enriquewph/Entrenador-pic/Entrenador_rev1/Render 3D.pdf

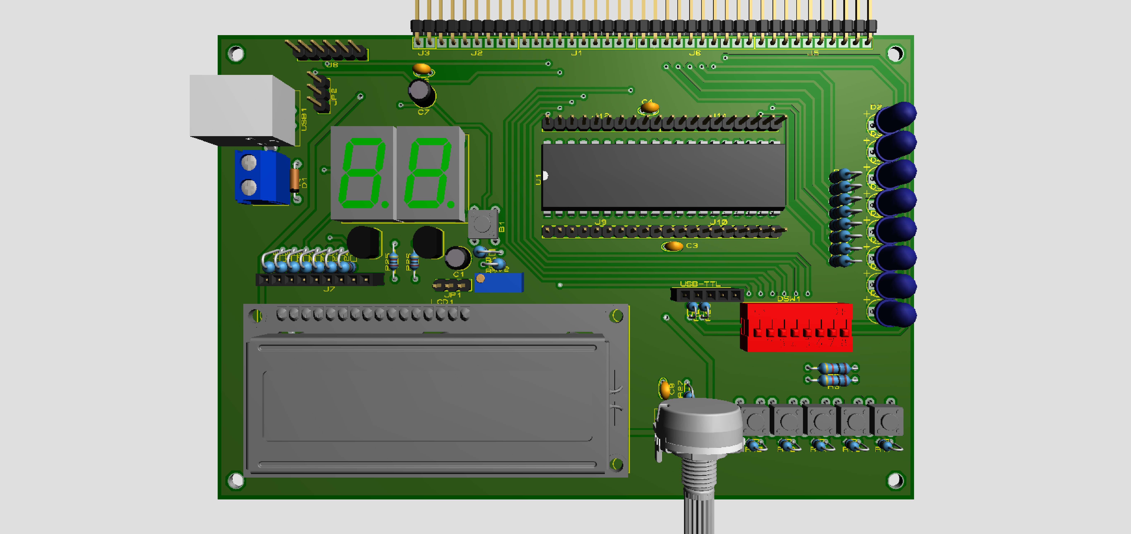
[picture p4: figure]
