enriquewph/Entrenador-pic/Entrenador_rev2/fotos_esquematico/BOM.pdf

Componente | Cantidad
Capacitor Electrolitico 1uFx16v | 1
Capacitor Electrolitico 100uFx16v | 1
Capacitor Cerámico 100nF | 6
Capacitor Cerámico 22pF | 2
Bornera 2 Terminales | 1
Tira de 40 pines hembra 2.54mm | 2
Tira de 40 pines macho 2.54mm | 2
Tira de 40 pines macho 90º 2.54mm | 1
Resistencia SMD 1206 4.7K | 3
Resistencia SMD 1206 10K | 8
Resistencia SMD 1206 470ohm | 7
Resistencia 1/4W THT 220ohm | 1
Trimmer 5k Multivuelta Vertical | 1
Led SMD 1206 Rojo | 7
Integrado SMD SOIC MCP2200-I/SO | 1
Microcontrolador DIP40 | 1
Optoacoplador AC 4N25 | 1
Regulador LM7805 TO-220 | 1
Zocalo DIP40 | 1
Pulsador 5x5mm | 4
Jack DC 2.5mm | 1
Dipswitch 8 bits Vertical | 1
Jumper | 3
Potenciometro 10k (Normal) | 1
Conector USB - B Hembra THT | 1
Cristal 12MHz Bajo perfil | 1
LCD 16x2 | 1
Diodo 1N4007 | 1
Placa lista p/entrenador | 1
Pies para placa | 4
