enriquewph/Entrenador-pic/Entrenador_rev3/Sch entrenador ITS Villada v1.pdf

# VCC

# MEMORIA

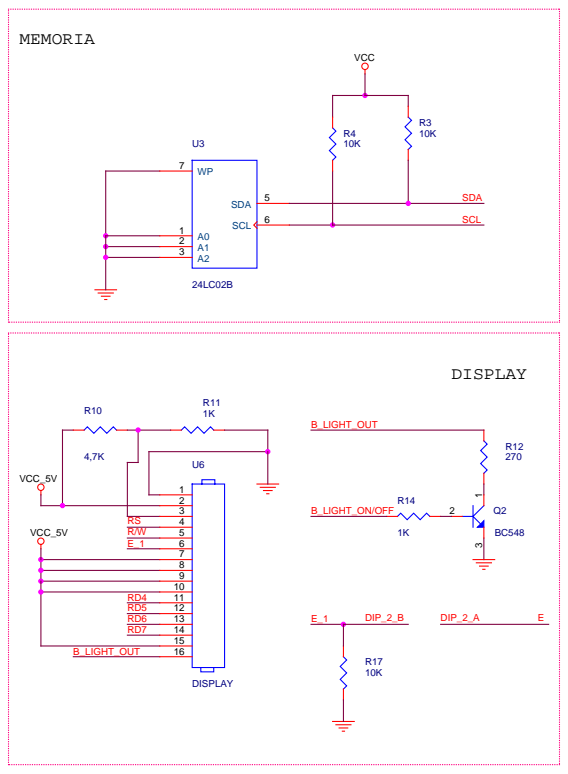
[picture p5: page 1]

VCC_5V | POTENCIA EN AC

## CRUCE_0

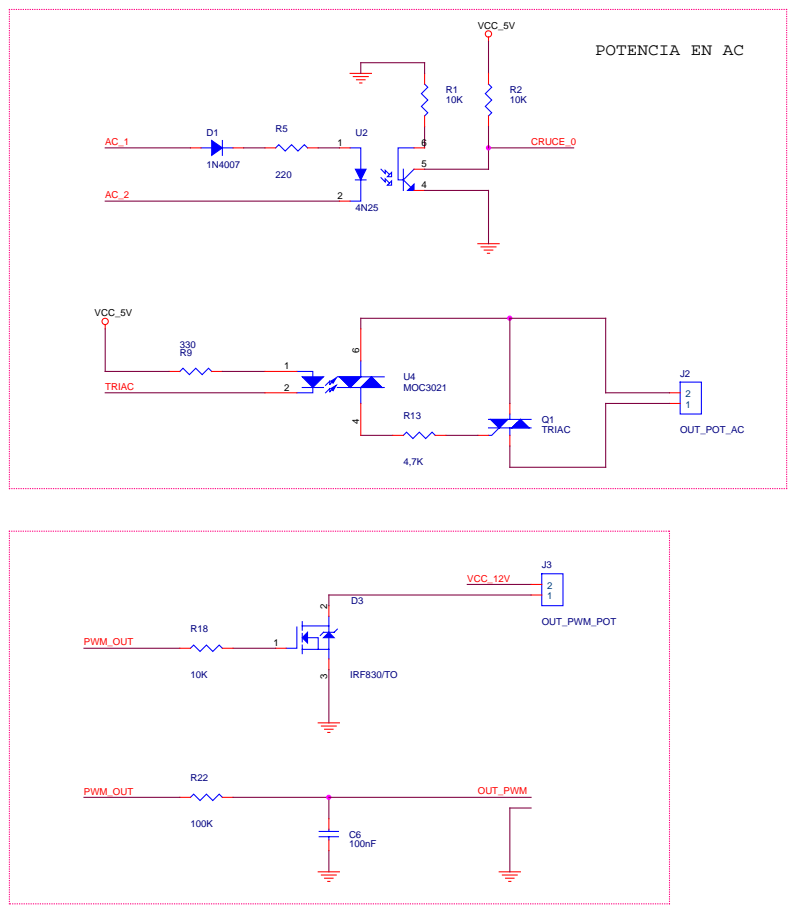
[picture p6: page 2]

U4 MOC3021

## VCC_5V

R6

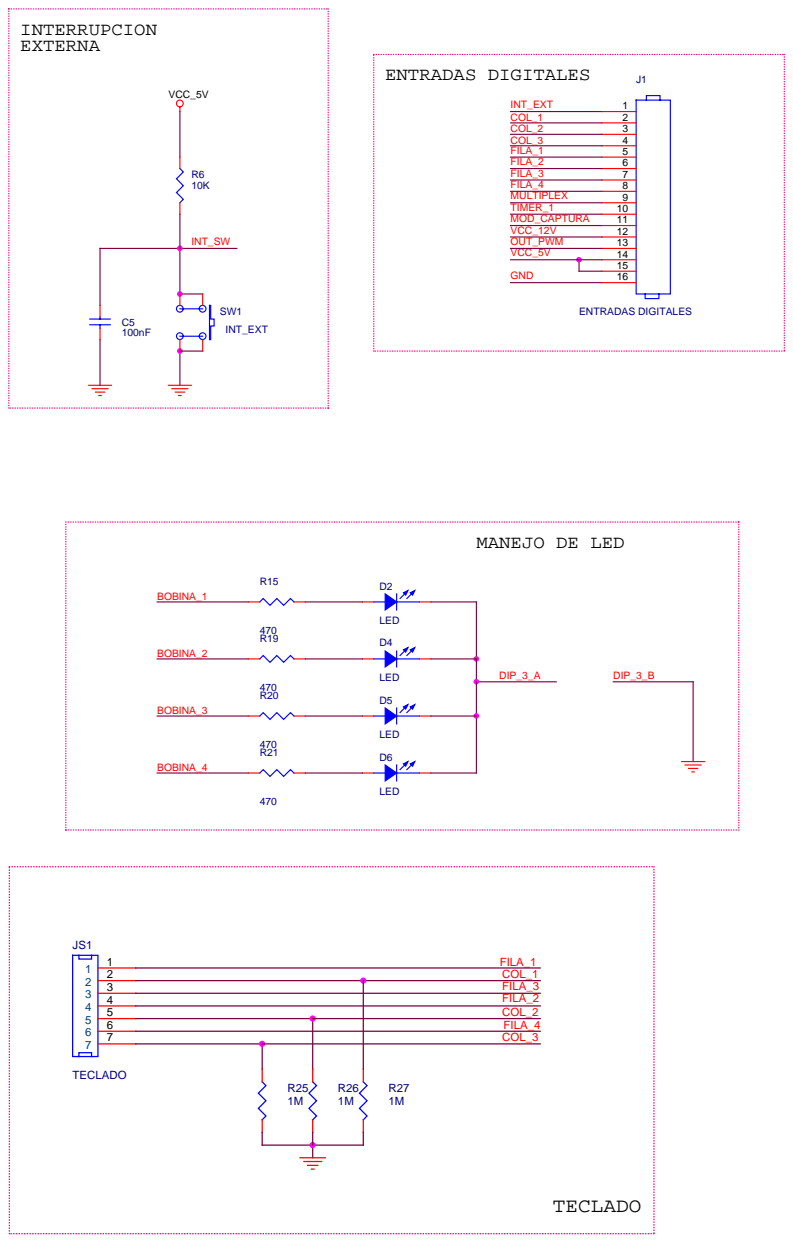
[picture p7: page 3]

R51

SW3

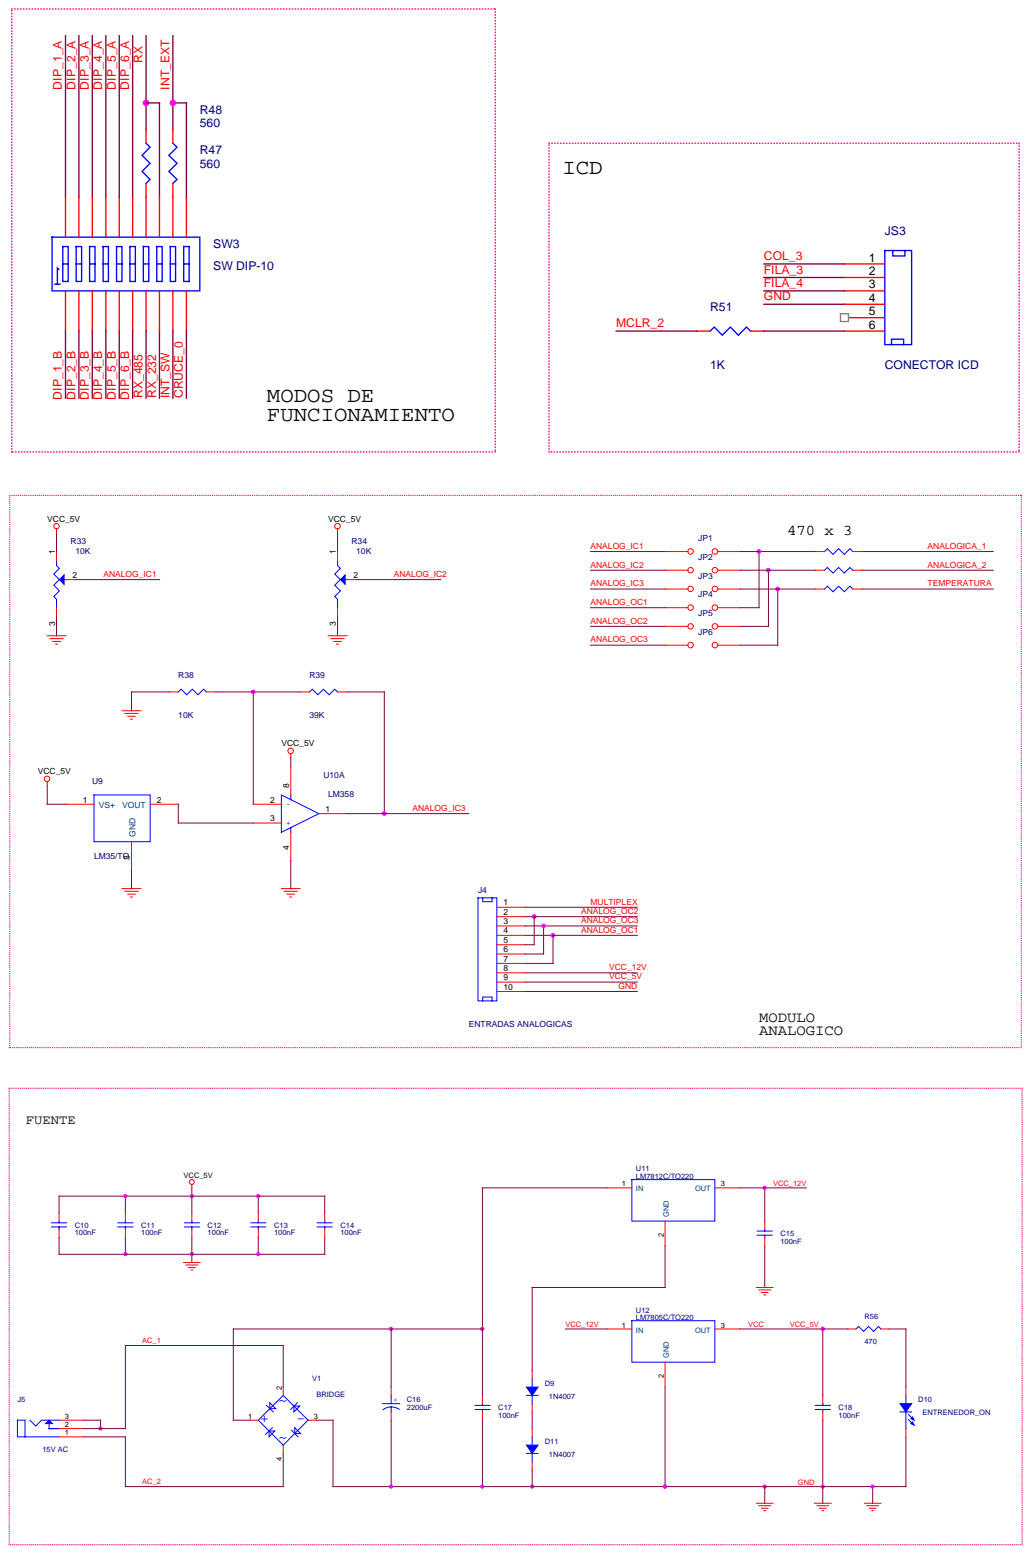
[picture p8: page 4]

C3 +

1uF

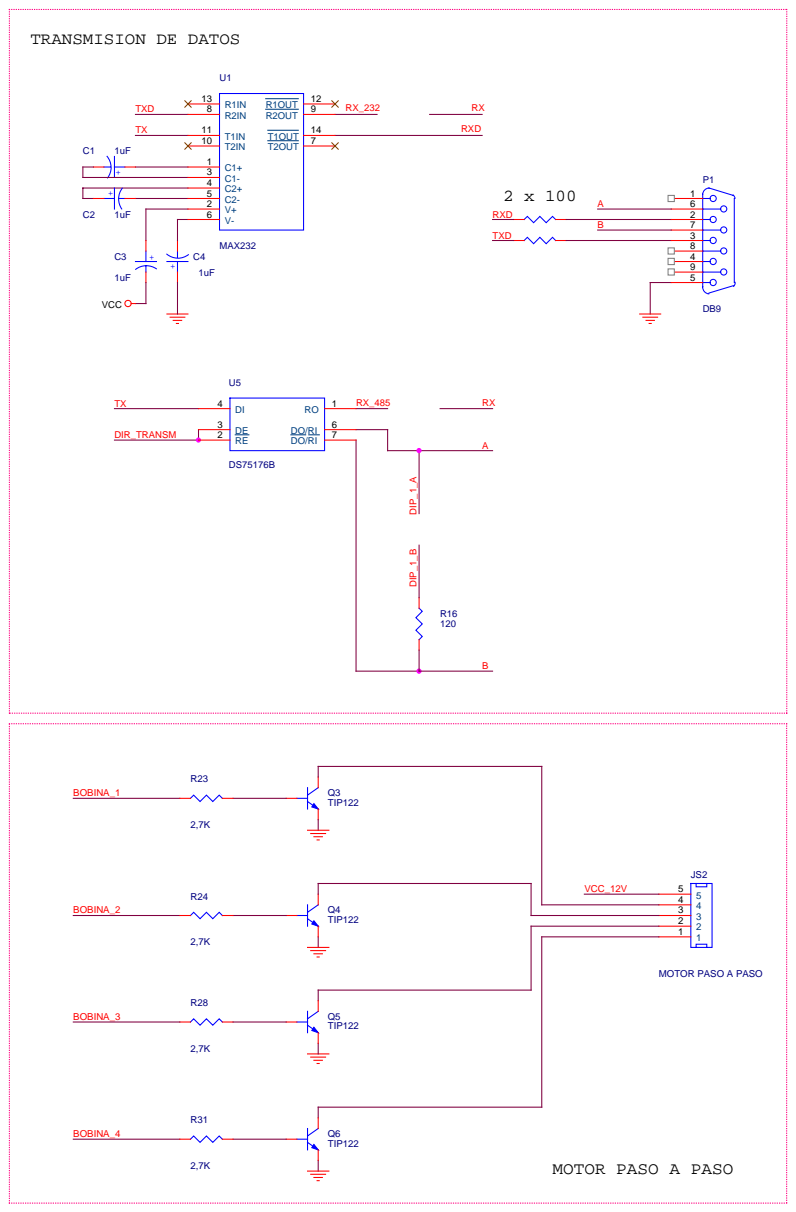
[picture p9: page 5]

## PROGRAMADOR

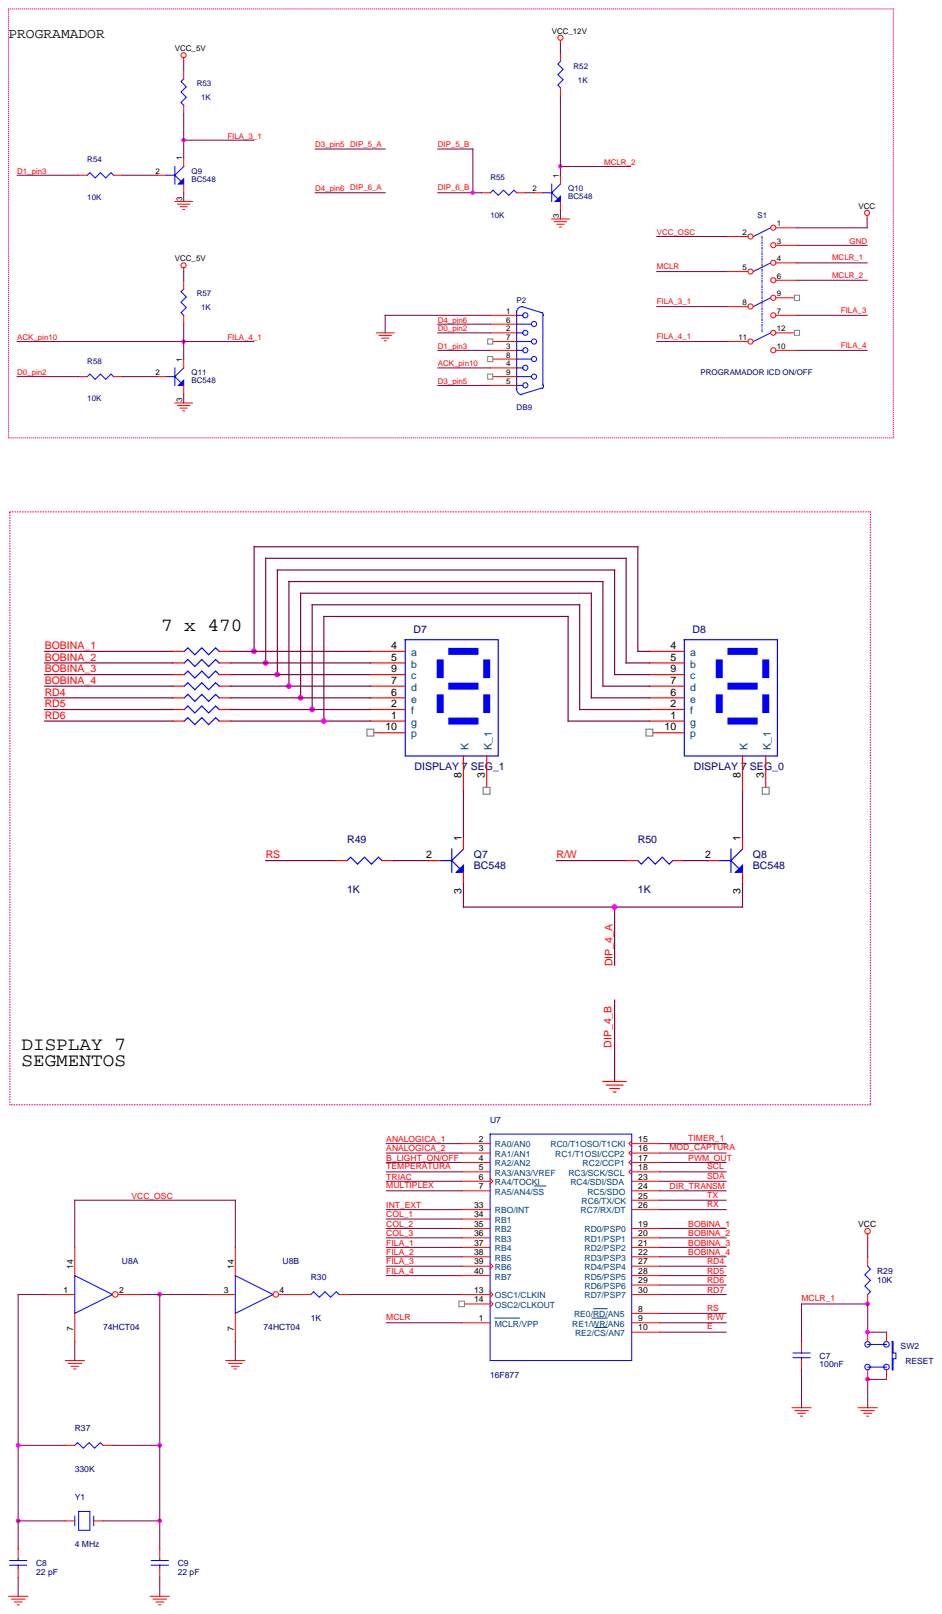
[picture p10: page 6]

PROGRAMADOR ICD ON/OFF
