enriquewph/Entrenador-pic/Entrenador_rev1/Manual de Usuario/Componentes Entrenador.pdf

1

# USB

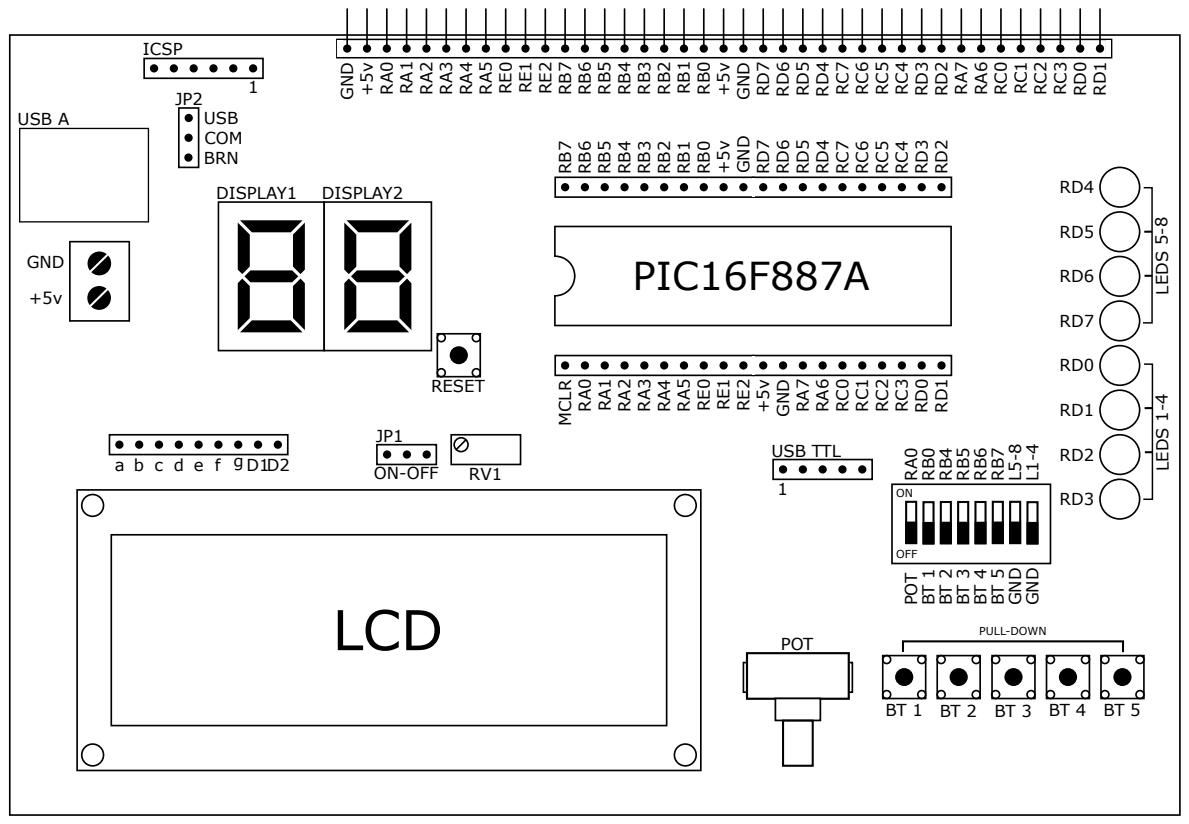
[picture p11: page 1]
GND; RESET; DISPLAY1; DISPLAY2; PIC16F887A; GND +5v; ON-OFF; BRN; COM; USB A; POT; GND GND; GND RD7; MCLR; ICSP; USB TTL; OFF; LCD; LEDS 5-8 LEDS 1-4; PULL-DOWN
