enriquewph/Entrenador-pic/Entrenador_rev1/Esquematico.pdf

# ALIMENTACIÓN DIPSWITCH

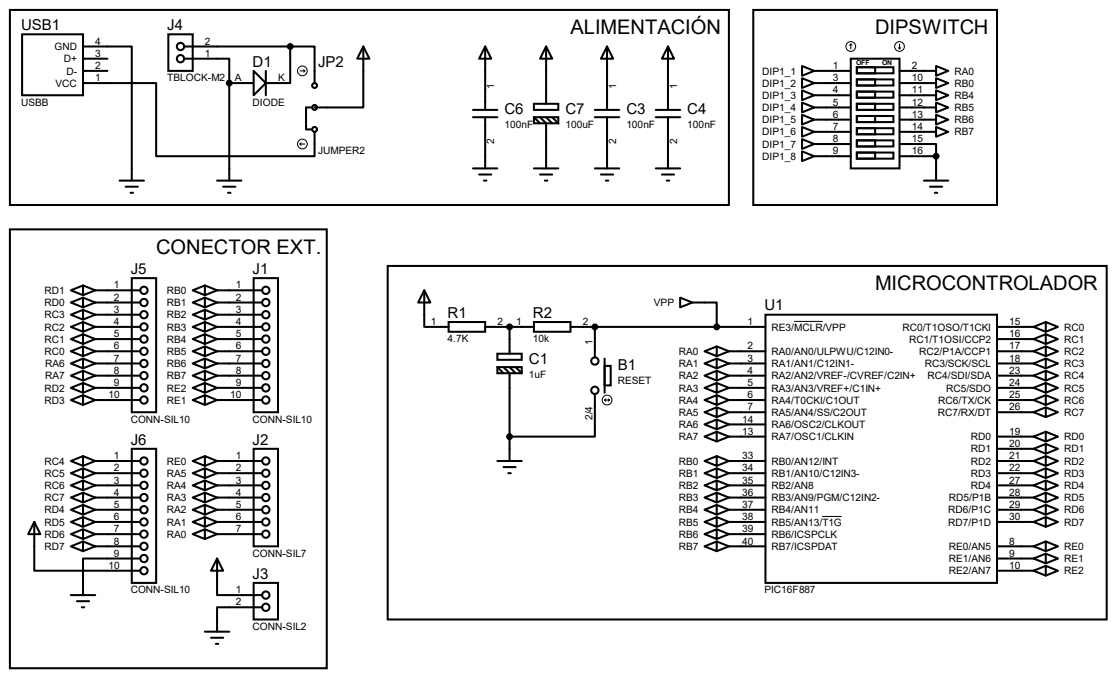
[picture p12: page 1]

B2 | 1 2

R10

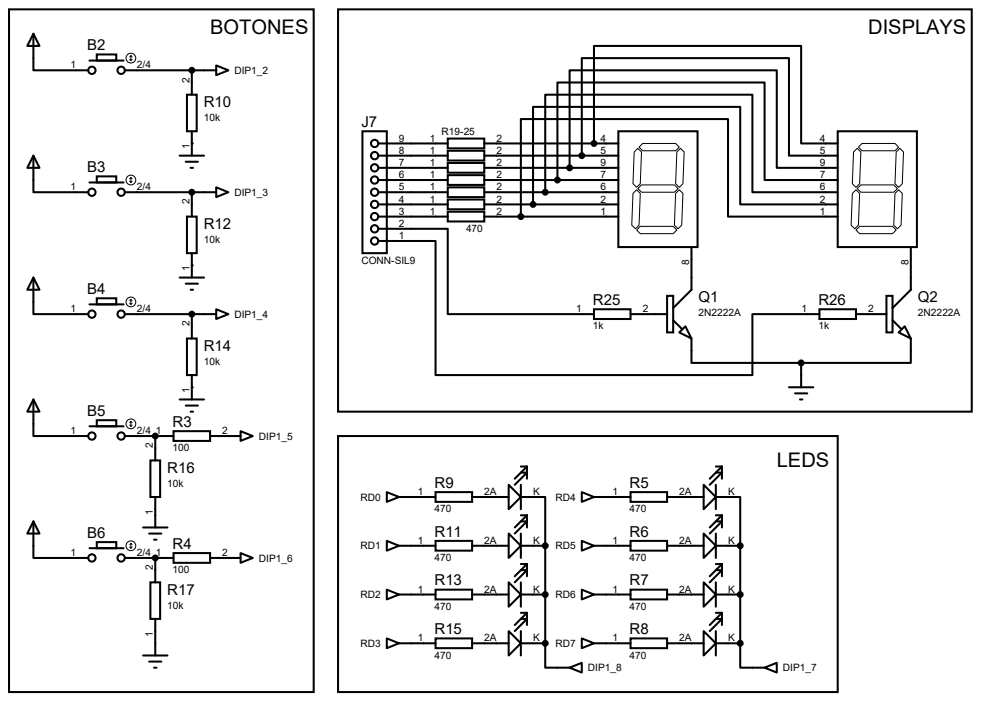
[picture p13: page 2]

# POTENCIOMETRO

# ICSP

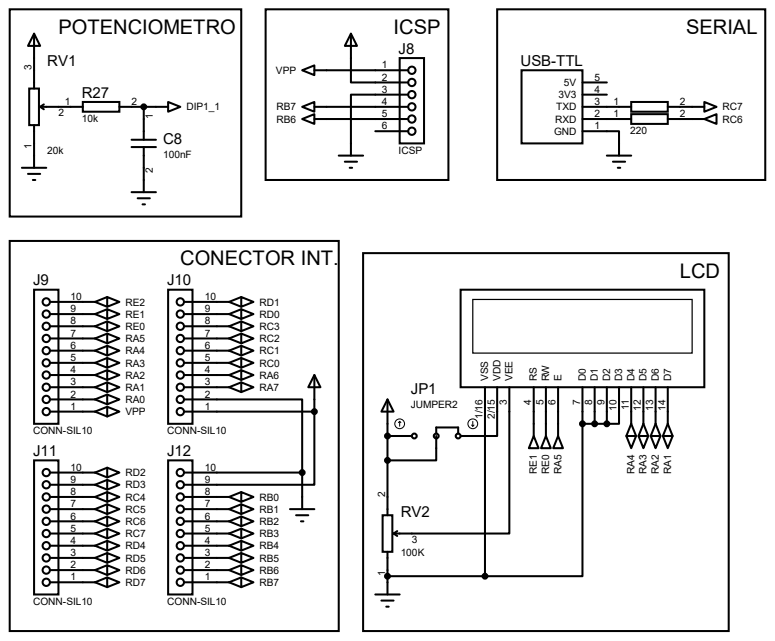
[picture p14: page 3]
