enriquewph/Entrenador-pic/Entrenador_rev2/bot resist.pdf

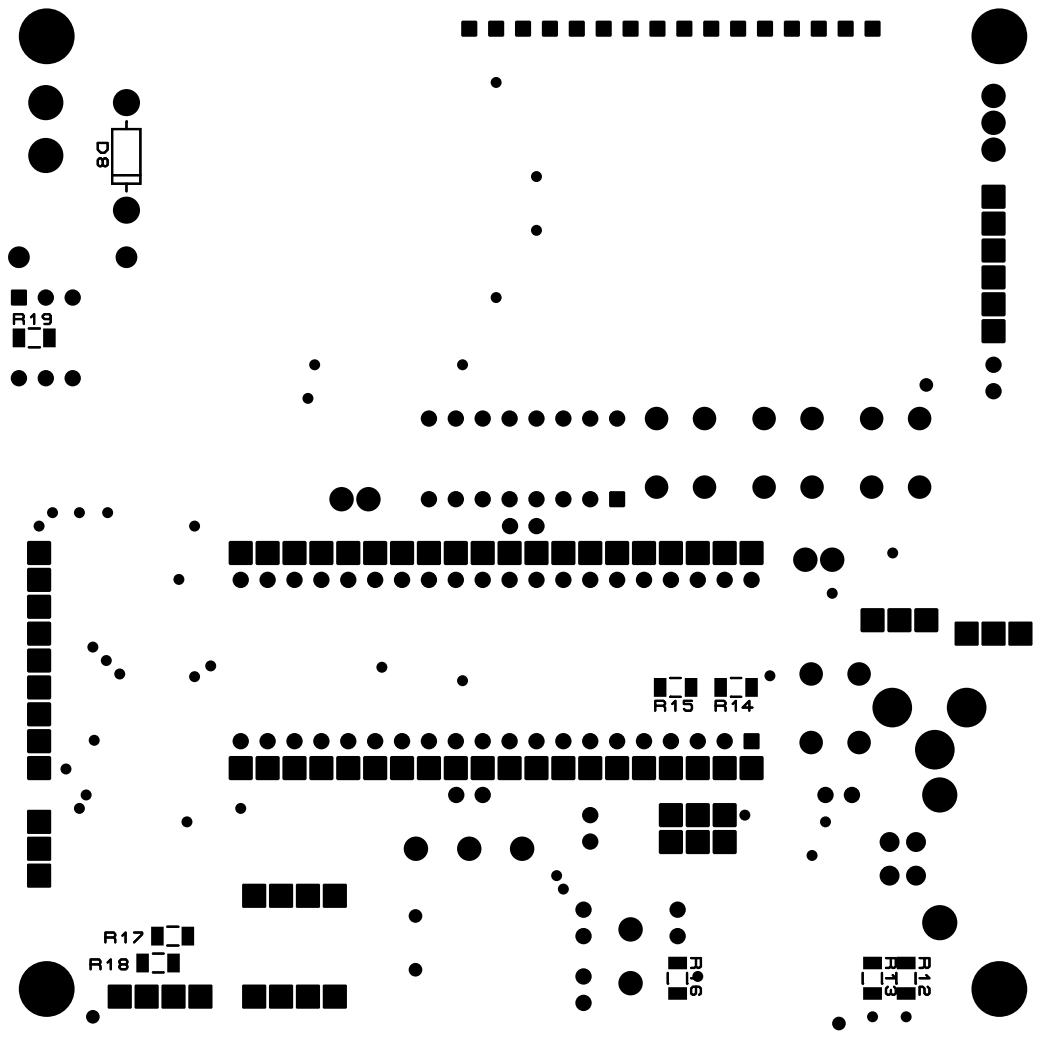
[picture p15: page 1]
