enriquewph/Entrenador-pic/Entrenador_rev2/Esquematico.pdf

# ALIMENTACIÓN

# DIPSWITCH

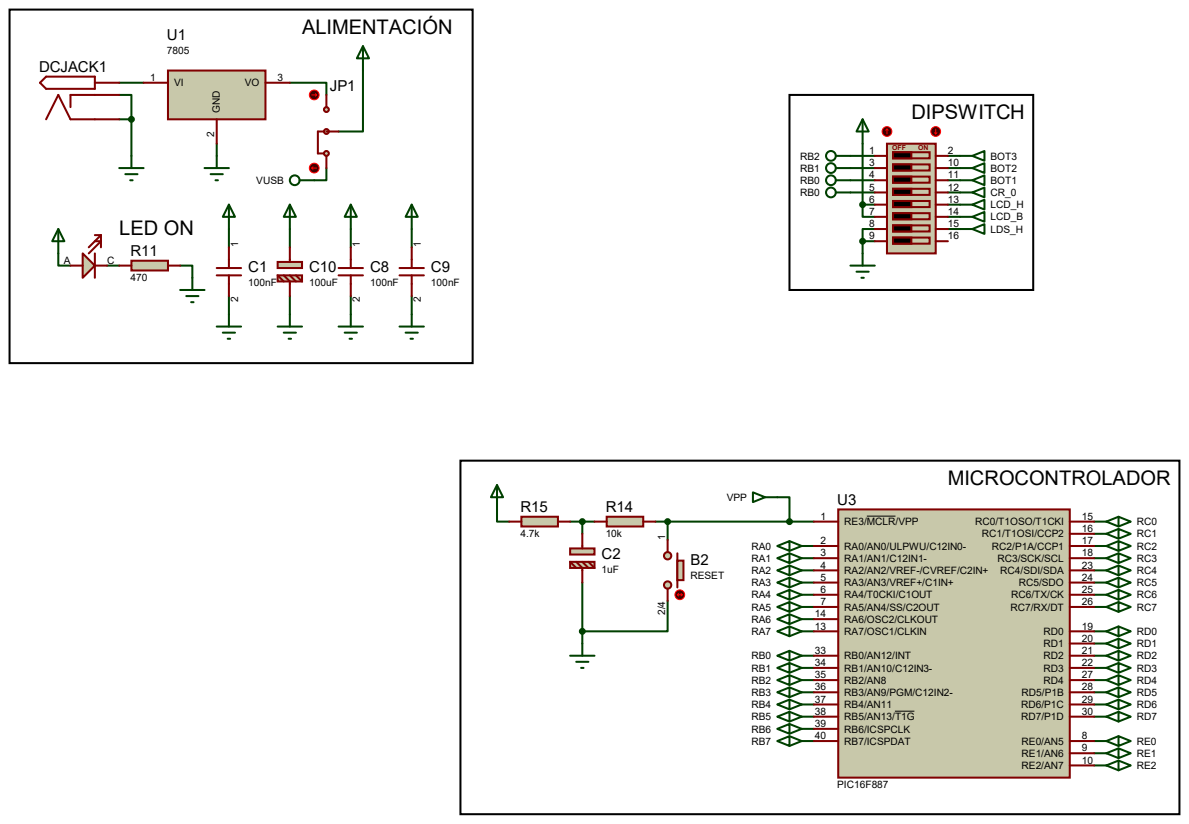
[picture p16: page 1]

R13

R12

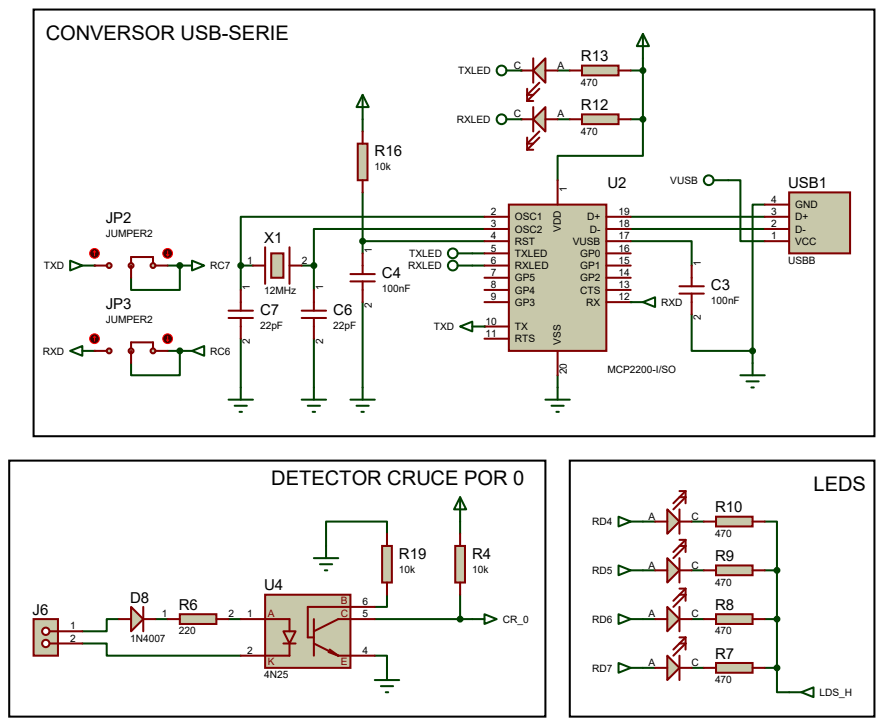
[picture p17: page 2]

# ICSP

J1

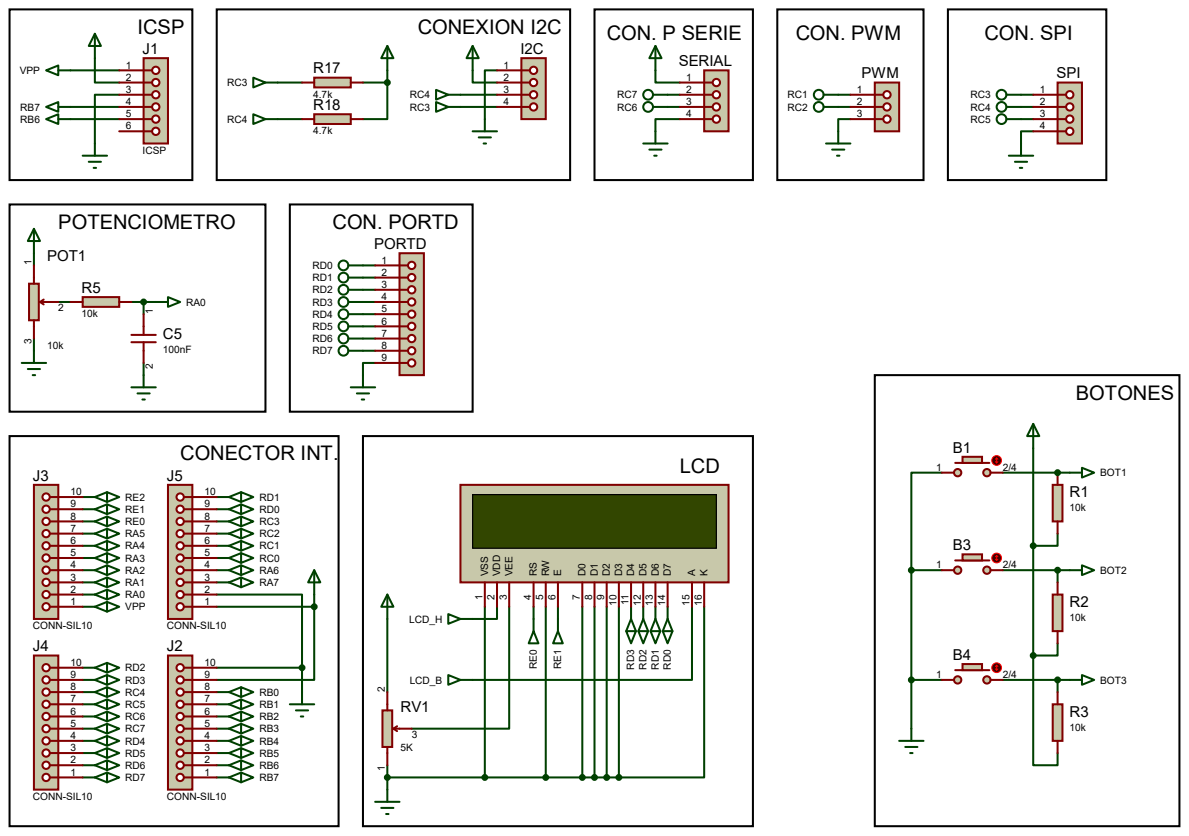
[picture p18: page 3]

LCD D⁷ 14 D⁶ 13 D⁵ 12 D⁴ 11 D³ 10 D²
