enriquewph/Entrenador-pic/Entrenador_rev2/topsilk.pdf

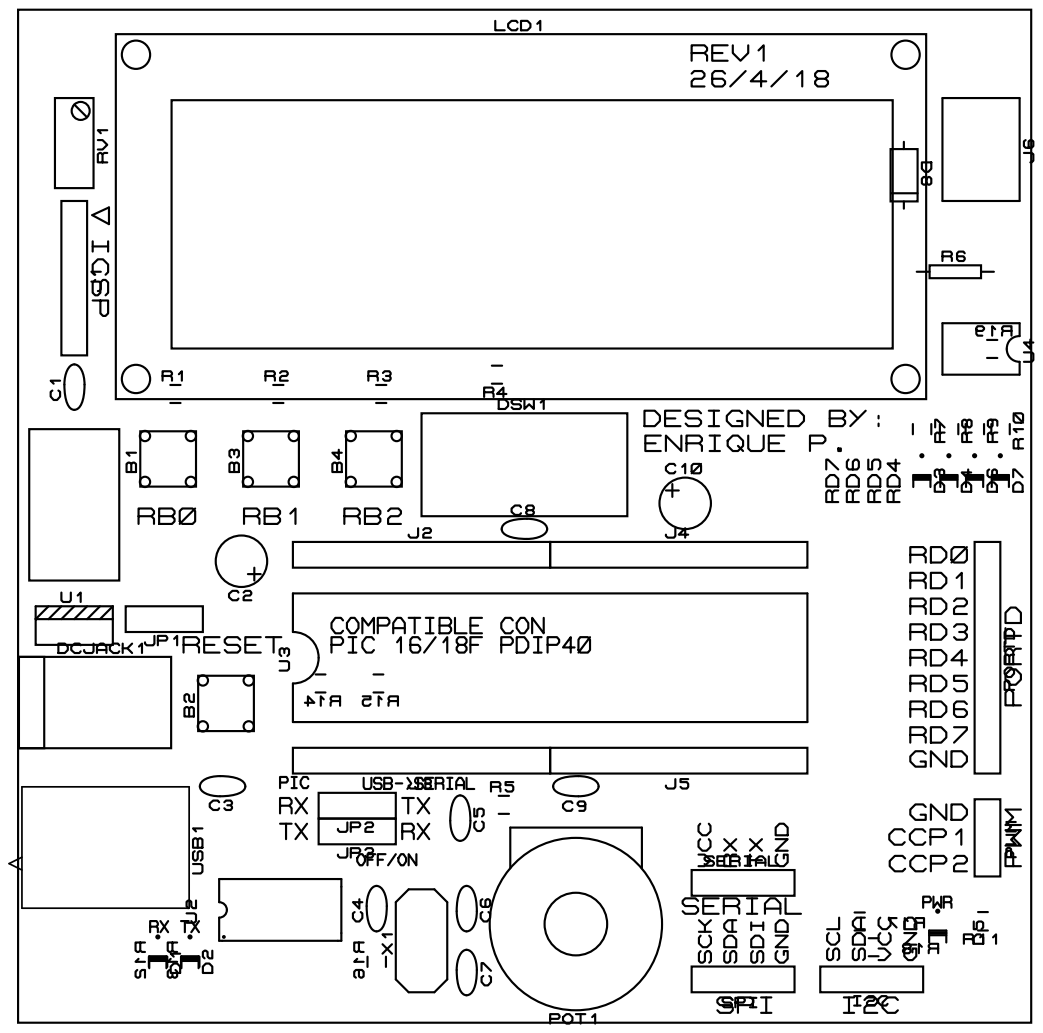
[picture p19: page 1]
