enriquewph/Entrenador-pic/Entrenador_rev1/Transfers/TRANSFER_A4_BOTTOM_COPPER.pdf

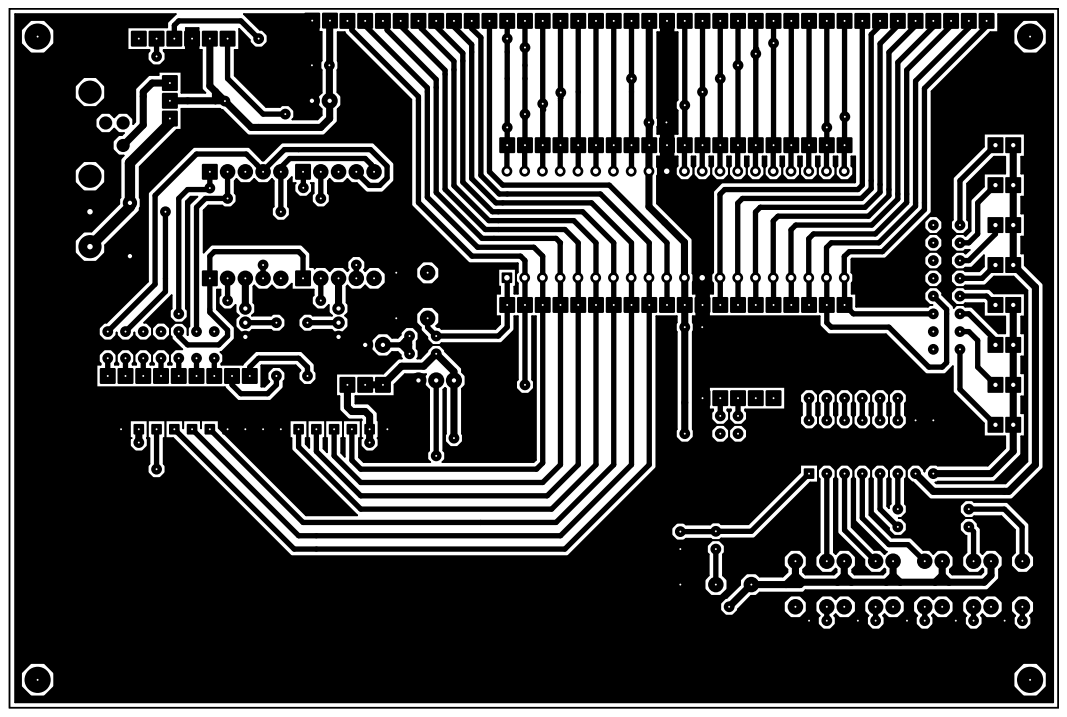
[picture p20: page 1]
