enriquewph/Entrenador-pic/Entrenador_rev1/Transfers/TRANSFER_A4_TOP_COPPER.pdf

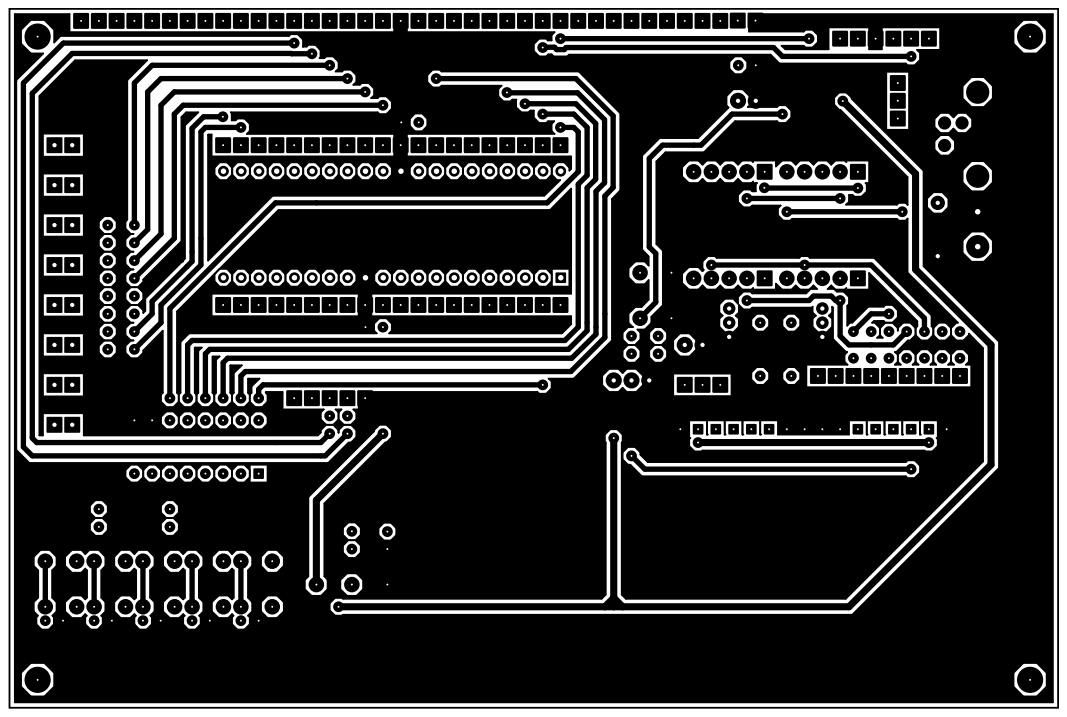
[picture p21: page 1]
