enriquewph/Entrenador-pic/Entrenador_rev1/Transfers/TRANSFER_A4_TOP_SILK.pdf

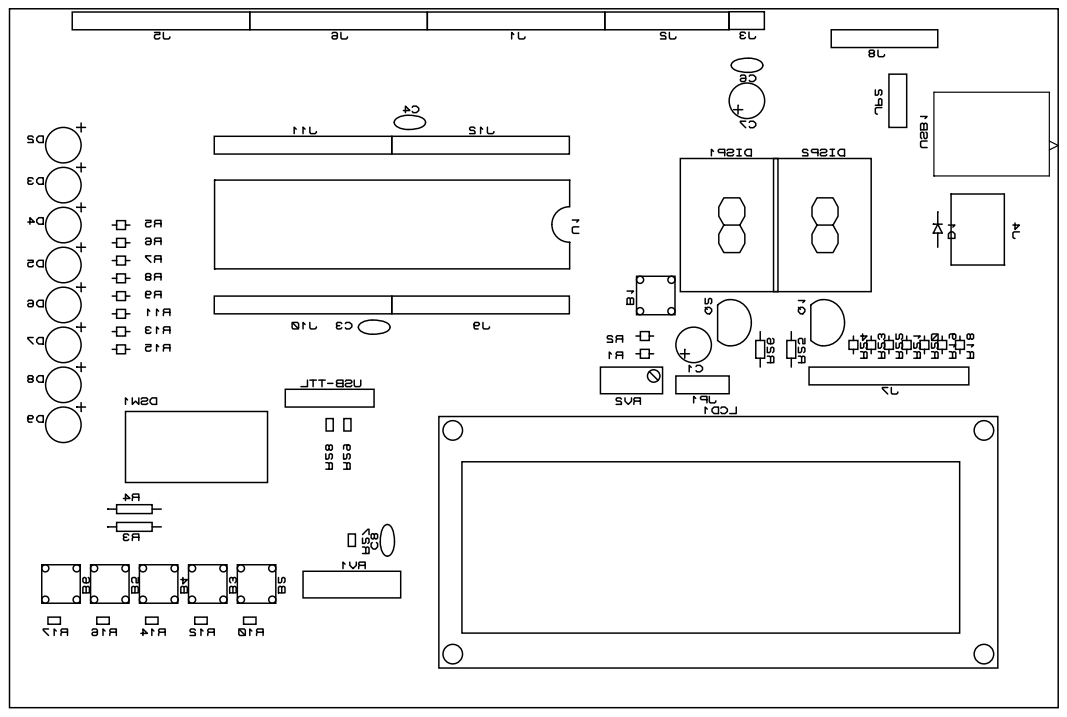
[picture p22: page 1]
