enriquewph/Entrenador-pic/Entrenador_rev1/Transfers/TRANSFER_A5_BOTTOM_COPPER.pdf

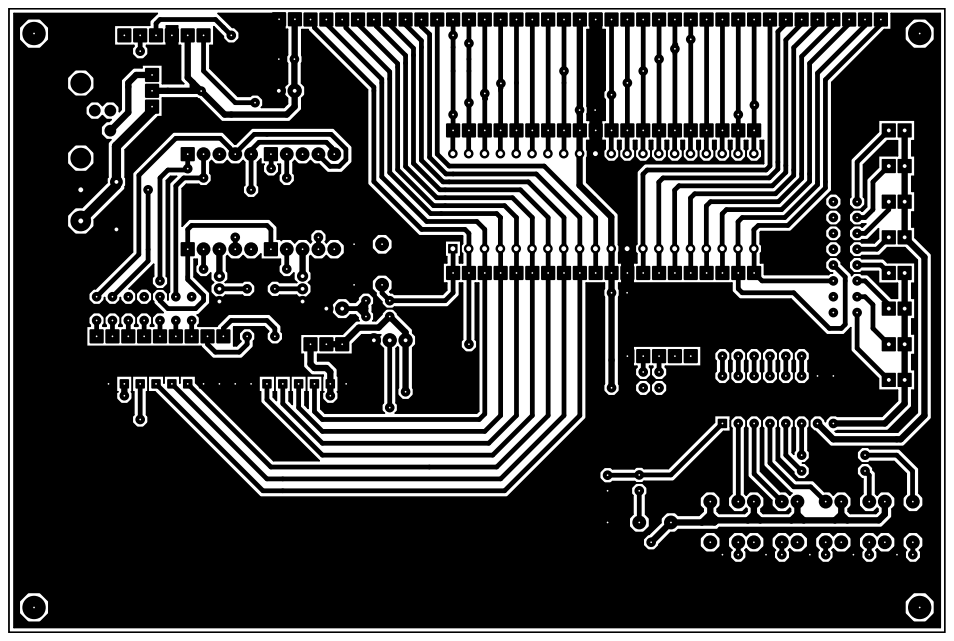
[picture p23: page 1]
