enriquewph/Entrenador-pic/Entrenador_rev1/Transfers/TRANSFER_A5_TOP_COPPER.pdf

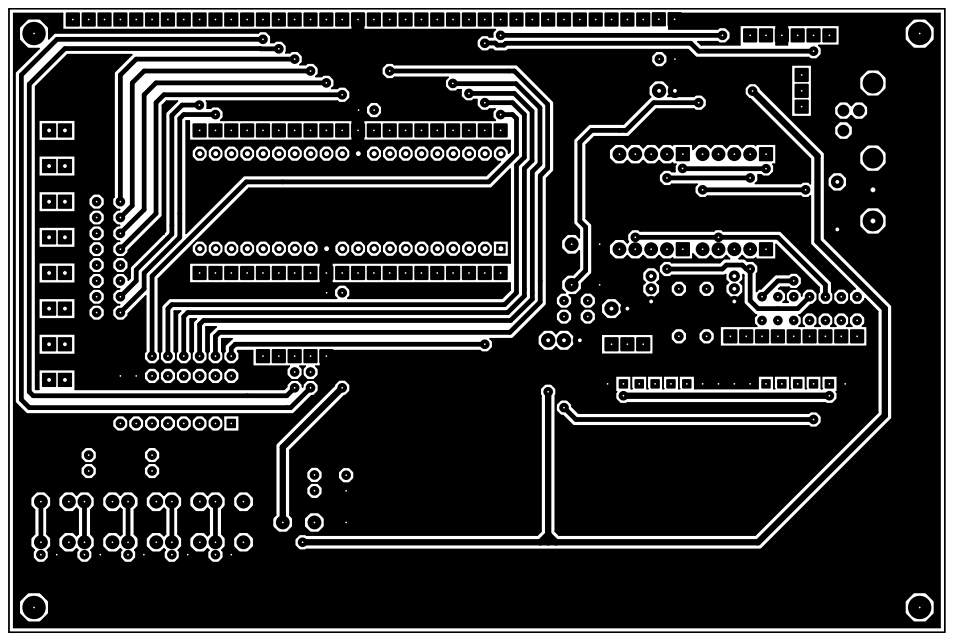
[picture p24: page 1]
