enriquewph/Entrenador-pic/Entrenador_rev1/Transfers/TRANSFER_A5_TOP_SILK.pdf

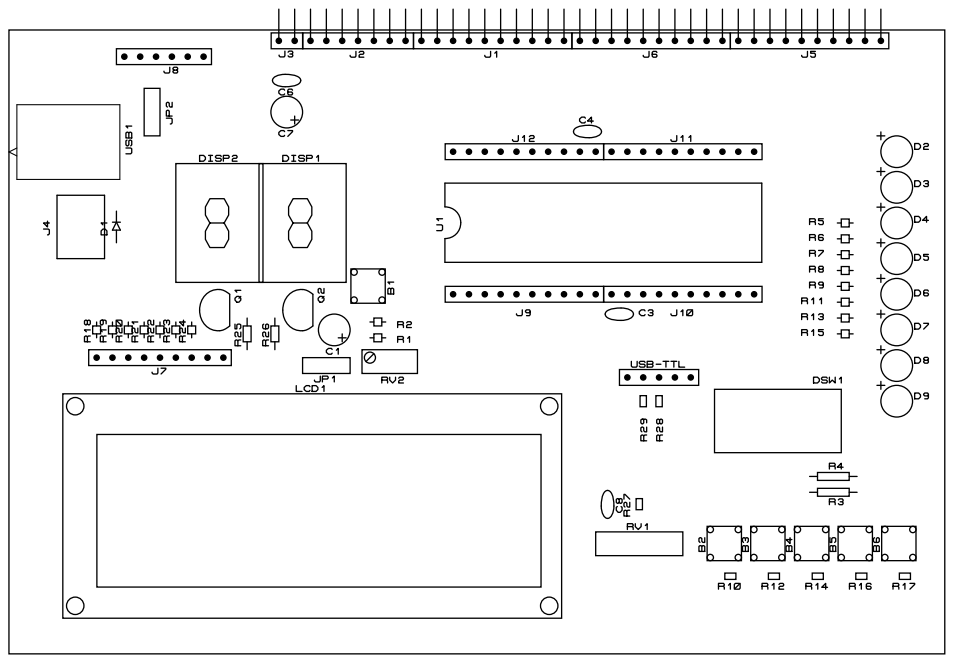
[picture p25: page 1]
