enriquewph/Entrenador-pic/(list of files, drawings)

Other design files:
Entrenador_rev1/Circuito nuevo.pdsprj
Entrenador_rev1/Circuito.pdsprj
Entrenador_rev1/Modulo 1/Circuito.pdsprj
Entrenador_rev2/Entrenador_rev2.pdsprj
Entrenador_rev3/Entrenador_rev3.pdsprj
Entrenador_rev3/EntrenadorITSV/EntrenadorITSV.PrjPcb
Entrenador_rev3/EntrenadorITSV/Sheet1.SchDoc
